kidsavagez/hydronoid/README.md

# hydronoid
IoT-Based Nutrition and Lighting Control to Grow Hydroponic Plants
